adnan5535/Pin-with-a-screen/Hardware/Datasheets and Reference/Horizontal Slide Switch Dimensional Drawing.JPG

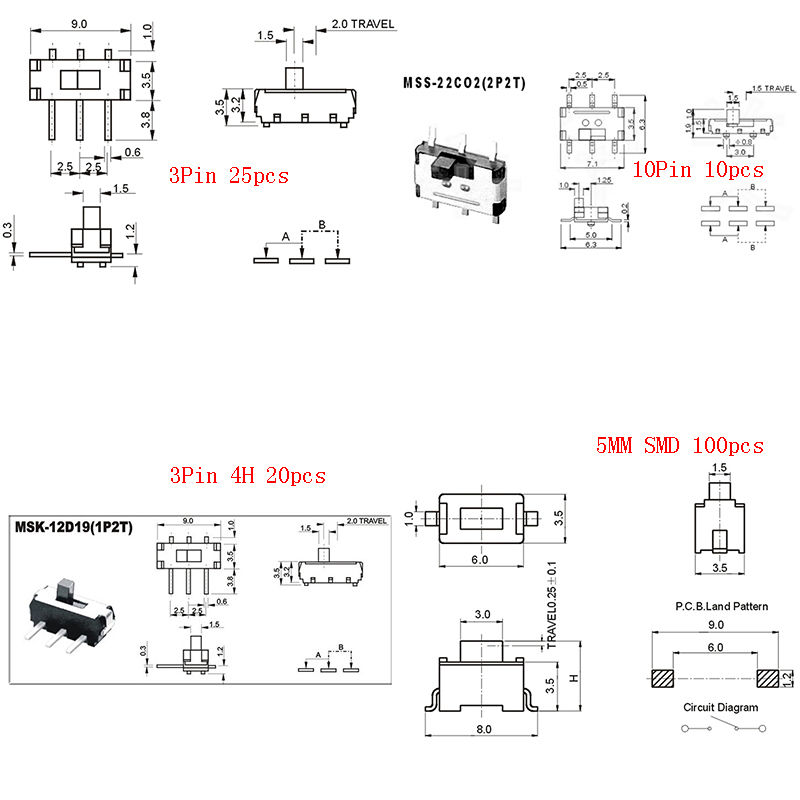
Hardware/Datasheets and Reference/Horizontal Slide Switch Dimensional Drawing.JPG
