adnan5535/Pin-with-a-screen/Hardware/Datasheets and Reference/Horizontal Switch Dimensional Drawing.JPG

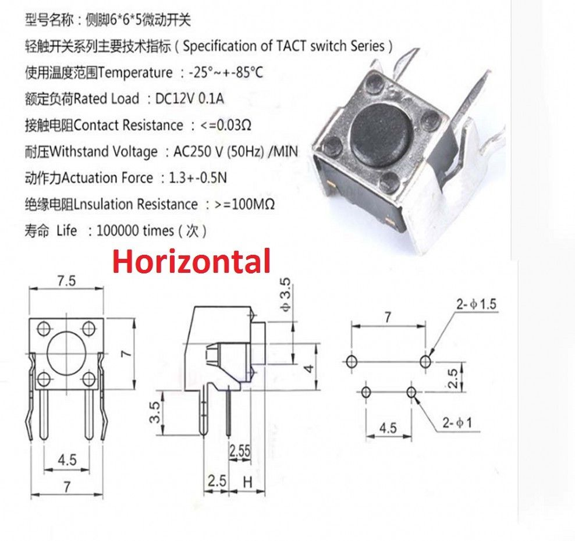
Hardware/Datasheets and Reference/Horizontal Switch Dimensional Drawing.JPG
