adnan5535/Pin-with-a-screen/Hardware/Datasheets and Reference/SD Card Holder/SD Card Footprint Reference_Pads.bmp

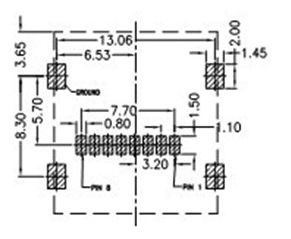
Hardware/Datasheets and Reference/SD Card Holder/SD Card Footprint Reference_Pads.bmp
