adnan5535/Pin-with-a-screen/Hardware/Datasheets and Reference/Seeedstudio Quote.PNG

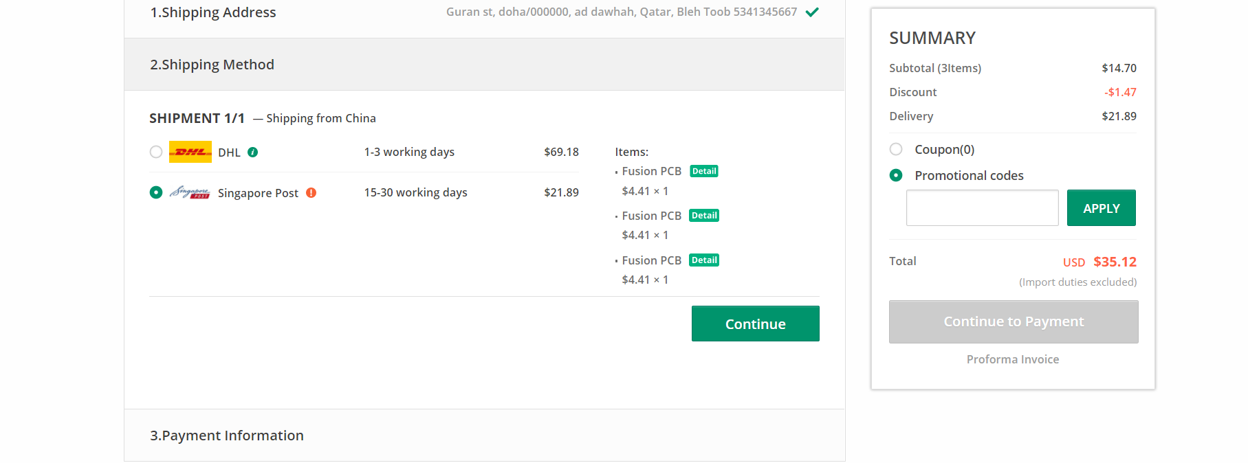
Hardware/Datasheets and Reference/Seeedstudio Quote.PNG
