adnan5535/Pin-with-a-screen/Hardware/Datasheets and Reference/Silkscreen Min-Size Reference.PNG

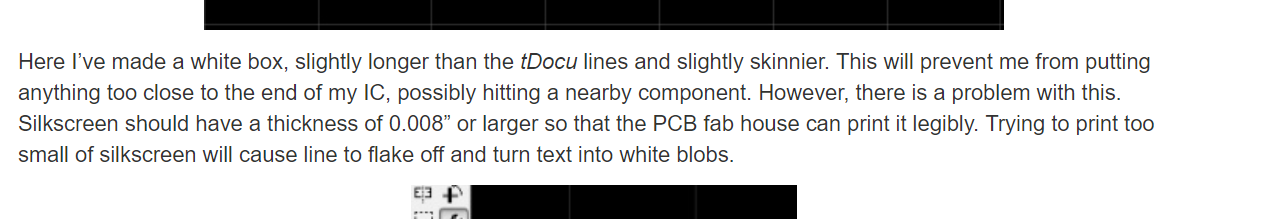
Hardware/Datasheets and Reference/Silkscreen Min-Size Reference.PNG
