adnan5535/Pin-with-a-screen/Hardware/Datasheets and Reference/Switching Regulator Files/BL8530 Footprint Reference_Desat_Monochrome.bmp

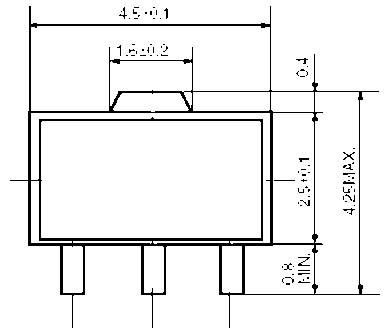
Hardware/Datasheets and Reference/Switching Regulator Files/BL8530 Footprint Reference_Desat_Monochrome.bmp
