adnan5535/Pin-with-a-screen/Hardware/Boards and Schematics/Pin-with-a-screen-3v3.brd

## EAGLE design Hardware/Boards and Schematics/Pin-with-a-screen-3v3.brd (2018-04-15)

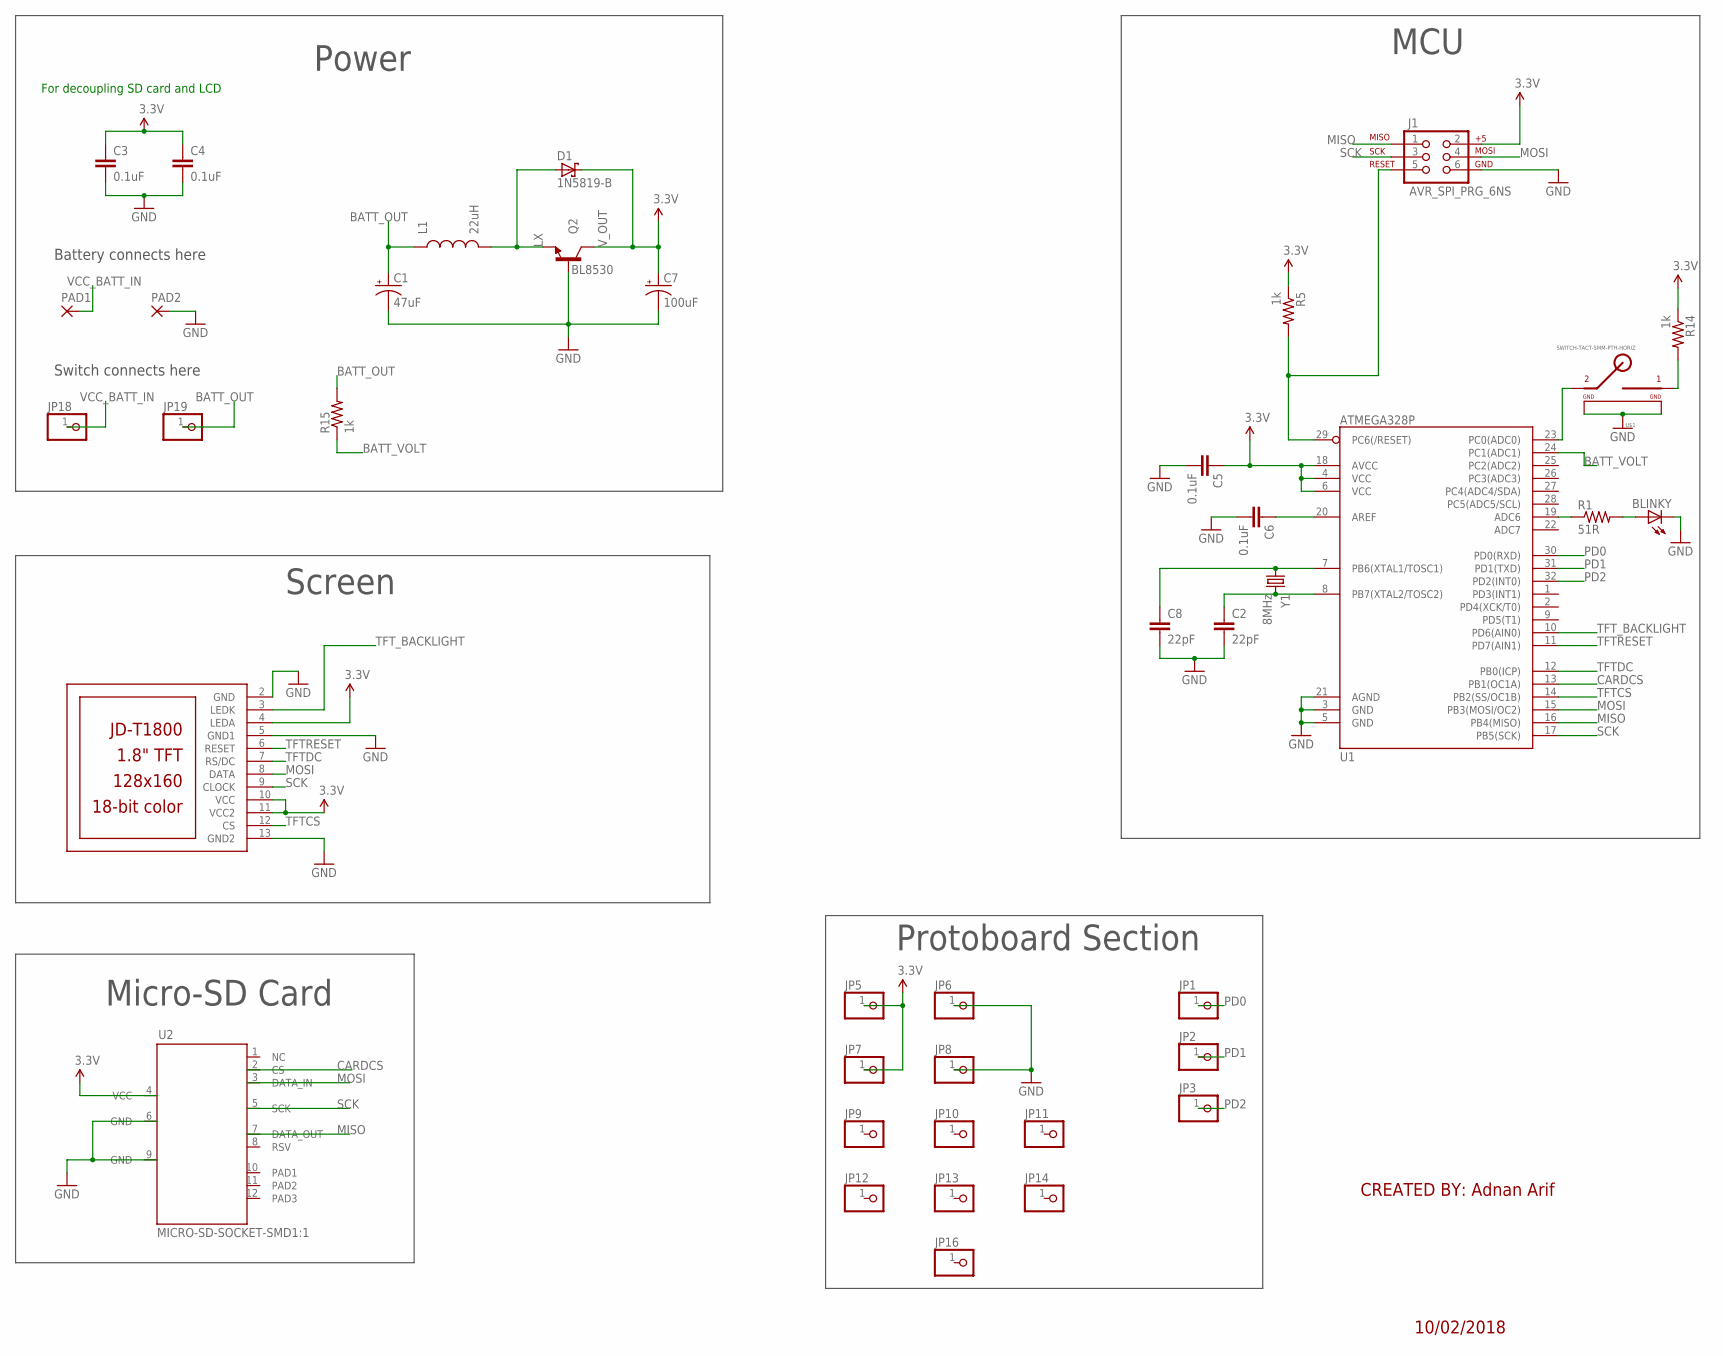
[picture p10: schematic Pin-with-a-screen-3v3.sch]

Parts:
BLINKY: Red; LED-0603
C1: 47uF; EIA3528-KIT
C2, C8: 22pF; 0603-CAP
C3, C4, C5, C6: 0.1uF; 0603-CAP
C7: 100uF; EIA3528-KIT
D1: 1N5819-B; DO41-7.6
J1: AVR_SPI_PRG_6NS; 2X3-NS
JP1, JP2, JP3, JP5, JP6, JP7, JP8, JP9, JP10, JP11, JP12, JP13, JP14, JP16, JP18, JP19: PINHD-1X1; 1X01
L1: 22uH; 0603
LCD2: JD-T1800
PAD1, PAD2: 2,15/1,0
Q2: BL8530; SOT89
R1: 51R; 0603-RES
R5, R14, R15: 1k; 0603-RES
U1: ATMEGA328P; TQFP32-08
U2: MICRO-SD-SOCKET-SMD1:1; MICRO-SD-SOCKET-SMD-1:1
U$1: SWITCH-TACT-5MM-PTH-HORIZ; 5MM-PTH
Y1: 8MHz; HC49UP

Connections:
3.3V: C3.1, C4.1, C5.1, C7.A (+), D1.C, J1.2, JP5.1, JP7.1, LCD2.4 (LEDA), LCD2.10 (VCC), LCD2.11 (VCC2), Q2.2 (C), R5.1, R14.1, U1.4 (VCC), U1.6 (VCC), U1.18 (AVCC), U2.4 (VCC)
BATT_OUT: C1.A (+), JP19.1, L1.1, R15.2
BATT_VOLT: R15.1, U1.24 (PC1(ADC1))
CARDCS: U1.13 (PB1(OC1A)), U2.2 (CS)
GND: BLINKY.C, C1.C (-), C2.2, C3.2, C4.2, C5.2, C6.2, C7.C (-), C8.2, J1.6, JP6.1, JP8.1, LCD2.2 (GND), LCD2.5 (GND1), LCD2.13 (GND2), PAD2.1, Q2.1 (B), U1.3 (GND), U1.5 (GND), U1.21 (AGND), U2.6 (GND), U2.9 (GND), U$1.GND, U$1.GND1
LX: D1.A, L1.2, Q2.3 (E)
MISO: J1.1, U1.16 (PB4(MISO)), U2.7 (DATA_OUT)
MOSI: J1.4, LCD2.8 (DATA), U1.15 (PB3(MOSI/OC2)), U2.3 (DATA_IN)
unnamed: U1.23 (PC0(ADC0)), U$1.2
unnamed: R14.2, U$1.1
unnamed: C6.1, U1.20 (AREF)
unnamed: C8.1, U1.7 (PB6(XTAL1/TOSC1)), Y1.1
unnamed: C2.1, U1.8 (PB7(XTAL2/TOSC2)), Y1.2
unnamed: J1.5, R5.2, U1.29 (PC6(/RESET))
unnamed: R1.1, U1.19 (ADC6)
unnamed: BLINKY.A, R1.2
PD0: JP1.1, U1.30 (PD0(RXD))
PD1: JP2.1, U1.31 (PD1(TXD))
PD2: JP3.1, U1.32 (PD2(INT0))
SCK: J1.3, LCD2.9 (CLOCK), U1.17 (PB5(SCK)), U2.5 (SCK)
TFTCS: LCD2.12 (CS), U1.14 (PB2(SS/OC1B))
TFTDC: LCD2.7 (RS/DC), U1.12 (PB0(ICP))
TFTRESET: LCD2.6 (RESET), U1.11 (PD7(AIN1))
TFT_BACKLIGHT: LCD2.3 (LEDK), U1.10 (PD6(AIN0))
VCC_BATT_IN: JP18.1, PAD1.1

Notes on the sheet:
For decoupling SD card and LCD
10/02/2018
Screen
Power
MCU
Micro-SD Card
CREATED BY: Adnan Arif
V_OUT
Battery connects here
Switch connects here
Protoboard Section

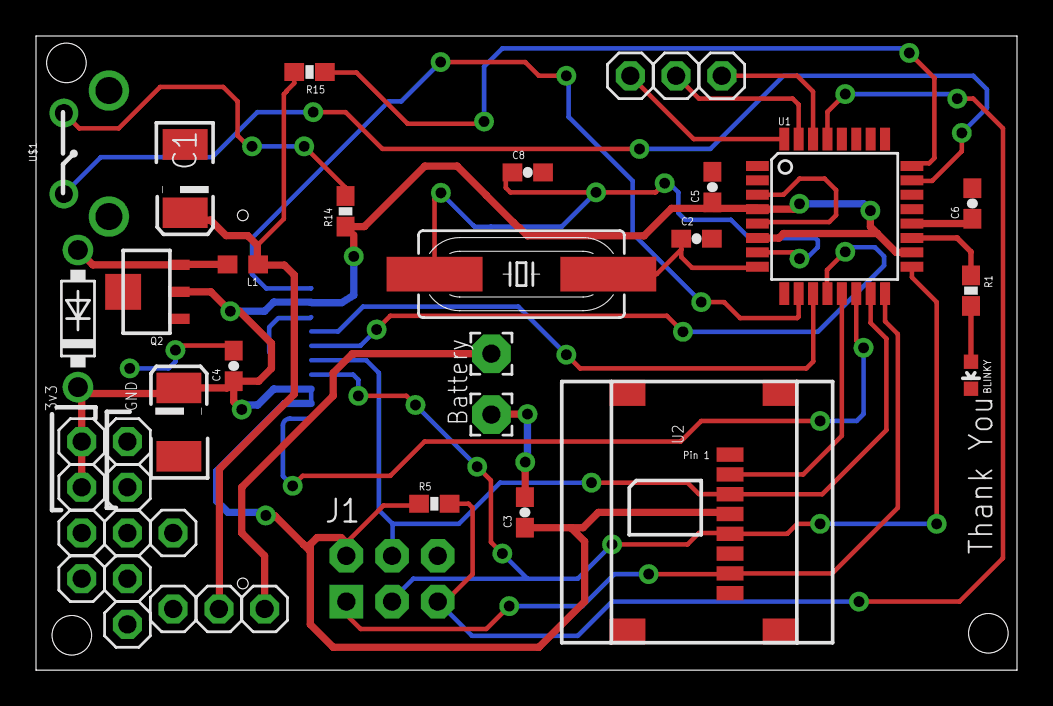
[picture p11: board Pin-with-a-screen-3v3.brd from above]

Board: 2 copper layers, 54.5 x 35.2 mm, 40 parts (1 on the bottom side), 25 nets.
