adnan5535/Pin-with-a-screen/Hardware/Boards and Schematics/Pin-with-a-screen.brd

## EAGLE design Hardware/Boards and Schematics/Pin-with-a-screen.brd (2018-04-07)

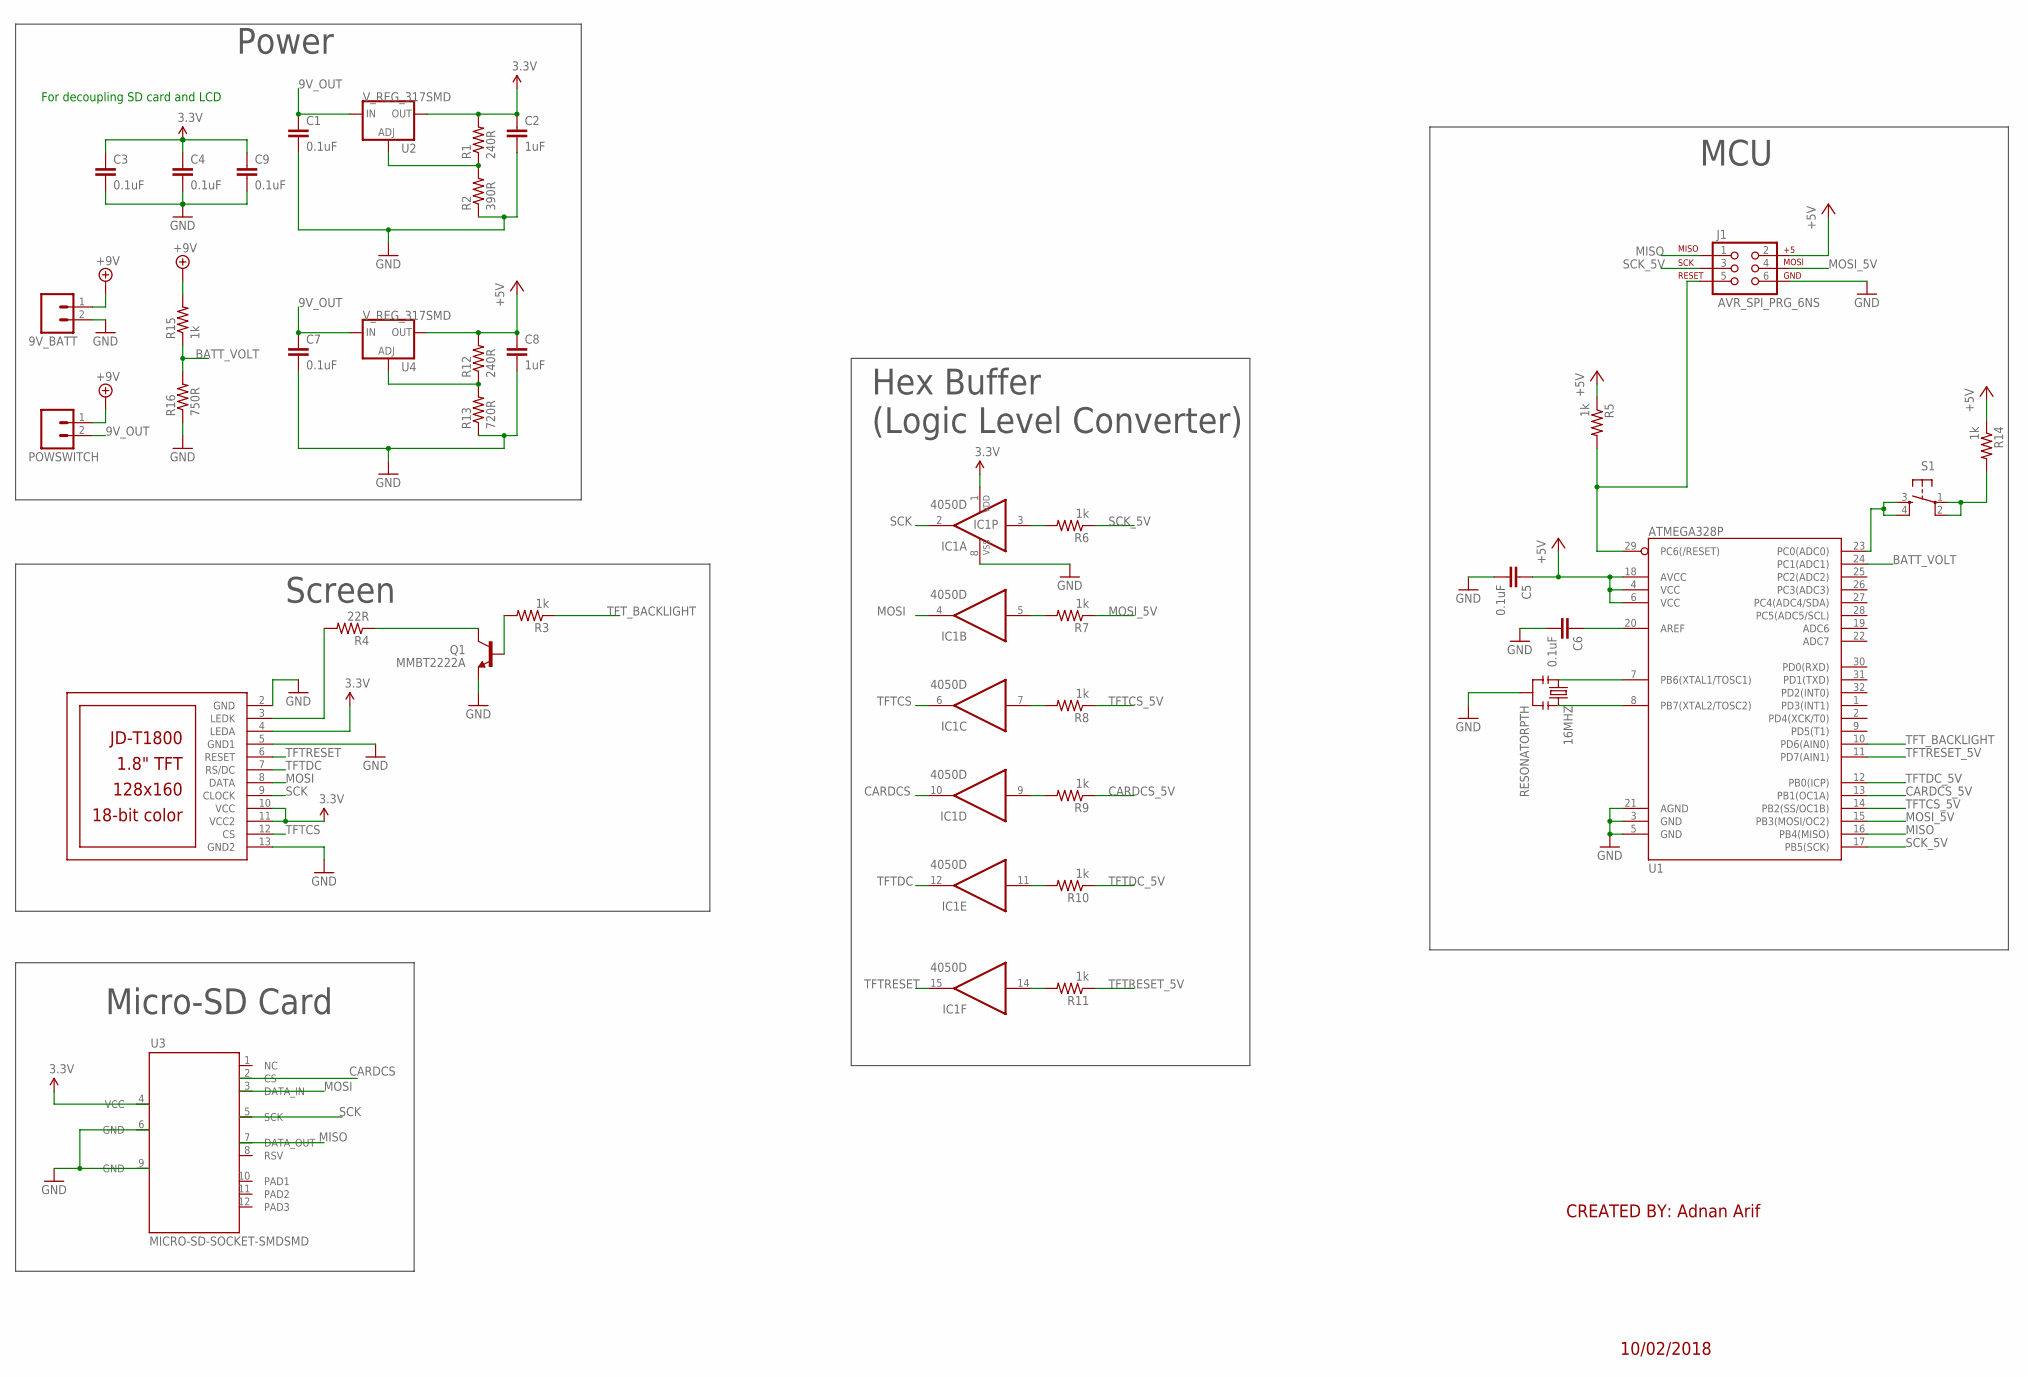
[picture p12: schematic Pin-with-a-screen.sch]

Parts:
9V_BATT: M02POGO_PIN_HOLES_ONLY; 1X02_PP_HOLES_ONLY
16MHZ: RESONATORPTH; RESONATOR-PTH
C1, C3, C4, C5, C6, C7, C9: 0.1uF; 0603-CAP
C2, C8: 1uF; 0603-CAP
IC1: 4050D; SO16
J1: AVR_SPI_PRG_6NS; 2X3-NS
LCD2: JD-T1800
POWSWITCH: M02POGO_PIN_HOLES_ONLY; 1X02_PP_HOLES_ONLY
Q1: MMBT2222A; SOT23-3
R1, R12: 240R; 0603-RES
R2: 390R; 0603-RES
R3, R5, R6, R7, R8, R9, R10, R11, R14, R15: 1k; 0603-RES
R4: 22R; 0603-RES
R13: 720R; 0603-RES
R16: 750R; 0603-RES
S1: TAC_SWITCHPTH; TACTILE-PTH
U1: ATMEGA328P; TQFP32-08
U2, U4: V_REG_317SMD; SOT223
U3: MICRO-SD-SOCKET-SMDSMD; MICRO-SD-SOCKET-SMD

Connections:
3.3V: C2.1, C3.1, C4.1, C9.1, IC1.1 (VDD), LCD2.4 (LEDA), LCD2.10 (VCC), LCD2.11 (VCC2), R1.2, U2.2 (OUT), U3.4 (VCC)
9V_OUT: C1.1, C7.1, POWSWITCH.2, U2.3 (IN), U4.3 (IN)
+5V: C5.1, C8.1, J1.2, R5.1, R12.2, R14.1, U1.4 (VCC), U1.6 (VCC), U1.18 (AVCC), U4.2 (OUT)
+9V: 9V_BATT.1, POWSWITCH.1, R15.2
BATT_VOLT: R15.1, R16.2, U1.24 (PC1(ADC1))
CARDCS: IC1.10 (O), U3.2 (CS)
CARDCS_5V: R9.1, U1.13 (PB1(OC1A))
GND: 9V_BATT.2, 16MHZ.2, C1.2, C2.2, C3.2, C4.2, C5.2, C6.2, C7.2, C8.2, C9.2, IC1.8 (VSS), J1.6, LCD2.2 (GND), LCD2.5 (GND1), LCD2.13 (GND2), Q1.2 (E), R2.1, R13.1, R16.1, U1.3 (GND), U1.5 (GND), U1.21 (AGND), U3.6 (GND), U3.9 (GND)
LEDK: LCD2.3 (LEDK), R4.2
MISO: J1.1, U1.16 (PB4(MISO)), U3.7 (DATA_OUT)
MOSI: IC1.4 (O), LCD2.8 (DATA), U3.3 (DATA_IN)
MOSI_5V: J1.4, R7.1, U1.15 (PB3(MOSI/OC2))
unnamed: S1.3, S1.4, U1.23 (PC0(ADC0))
unnamed: R14.2, S1.1, S1.2
unnamed: C6.1, U1.20 (AREF)
unnamed: 16MHZ.1, U1.7 (PB6(XTAL1/TOSC1))
unnamed: 16MHZ.3, U1.8 (PB7(XTAL2/TOSC2))
unnamed: J1.5, R5.2, U1.29 (PC6(/RESET))
unnamed: IC1.3 (I), R6.2
unnamed: IC1.5 (I), R7.2
unnamed: IC1.7 (I), R8.2
unnamed: IC1.9 (I), R9.2
unnamed: IC1.11 (I), R10.2
unnamed: IC1.14 (I), R11.2
unnamed: R1.1, R2.2, U2.1 (ADJ)
unnamed: R12.1, R13.2, U4.1 (ADJ)
SCK: IC1.2 (O), LCD2.9 (CLOCK), U3.5 (SCK)
SCK_5V: J1.3, R6.1, U1.17 (PB5(SCK))
TFTCS: IC1.6 (O), LCD2.12 (CS)
TFTCS_5V: R8.1, U1.14 (PB2(SS/OC1B))
TFTDC: IC1.12 (O), LCD2.7 (RS/DC)
TFTDC_5V: R10.1, U1.12 (PB0(ICP))
TFTRESET: IC1.15 (O), LCD2.6 (RESET)
TFTRESET_5V: R11.1, U1.11 (PD7(AIN1))
TFT_BACKLIGHT: R3.1, U1.10 (PD6(AIN0))
TRAN_BASE: Q1.1 (B), R3.2
TRAN_COLLECTOR: Q1.3 (C), R4.1

Notes on the sheet:
For decoupling SD card and LCD
10/02/2018
Screen
Power
MCU
Micro-SD Card
Hex Buffer (Logic Level Converter)
CREATED BY: Adnan Arif

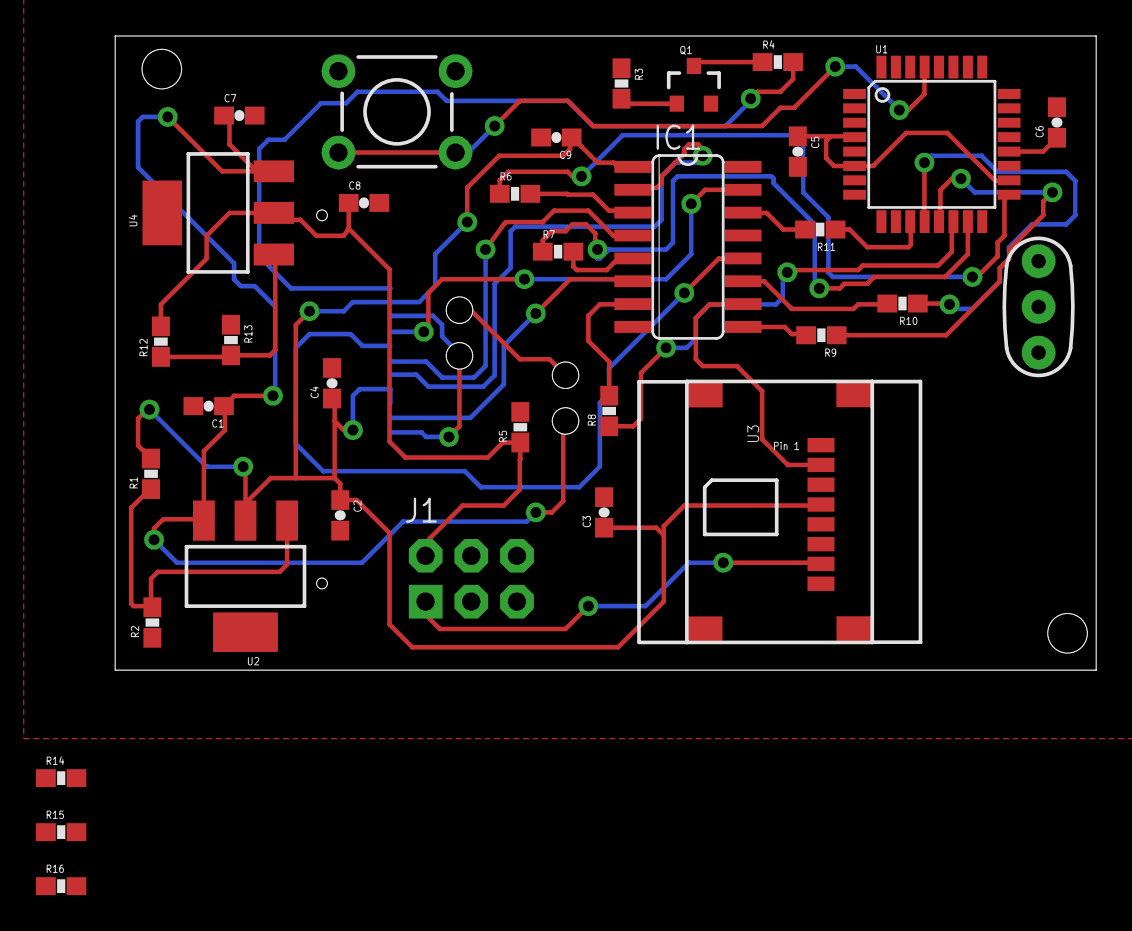
[picture p13: board Pin-with-a-screen.brd from above]

Board: 2 copper layers, 54.5 x 35.2 mm, 37 parts (1 on the bottom side), 37 nets.
