adnan5535/Pin-with-a-screen/(commit log)

2018-04-08 Removed transistor-resistor logic level shifter
    Logic level shifter was used for PWM-ing backlight signal for screen.
    Since MCU operates on 3v3 logic like screen, level shifter is not
    necessary.
    [Pin-with-a-screen-3v3.brd, Pin-with-a-screen-3v3.sch]
2018-04-08 Changed led to red and series resistor to 51R
    [Pin-with-a-screen-3v3.brd, Pin-with-a-screen-3v3.sch]
2018-04-09 Added protoboard section
    [Pin-with-a-screen-3v3.brd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]
2018-04-14 Added "thank you", protoboard labels, gerbers
    Added thank you message to tnames layer
    Added labels for 3v3 and GND sections of protoboard
    Generated gerbers using SEEED studio and Sparkfun CAM files. Added .zip
    files for both
    [Pin-with-a-screen-3v3.brd]
2018-04-15 Changed button to horizontal type, added screw-hole
    Push button changed to horizontal with custom footprint. It replaced the
    vertical push button. Some traces were re-routed to accomodate it.
    Screw-hole added to bottom left of board since top left one could have
    issues with push button.
    [Pin-with-a-screen-3v3.brd, Pin-with-a-screen-3v3.sch]
2018-04-15 Generated gerbers using Seeed studio CAM file
2018-04-15 Changed switch configuration, generated gerbers
    Switch now connects directly to bottom side of PCB instead of being
    wired to pads. Horizontal SPDT switch selected.
    New gerbers generated with Seeed Studio CAM file.
    [BOM.xlsx, Pin-with-a-screen-3v3.brd, Pin-with-a-screen-3v3.sch, bom-Pin-with-a-screen-3v3.csv]
2018-04-15 Changed horizontal button position
    Moved horizontal button inwards so that it doesn't stick out so much.
    [BOM.xlsx]
2018-04-15 Generated gerbers
    Generated new gerbers with Seeed studio CAM job file. Also deleted
    autosave files.
